ZONDE00/PWR_PCB/README.md

# GS_PCB
Power delivery PCB design files
