ZONDE00/PWR_PCB/PWR_PCB.kicad_pcb

## KiCad design PWR_PCB.kicad_pcb (2022-12-13)

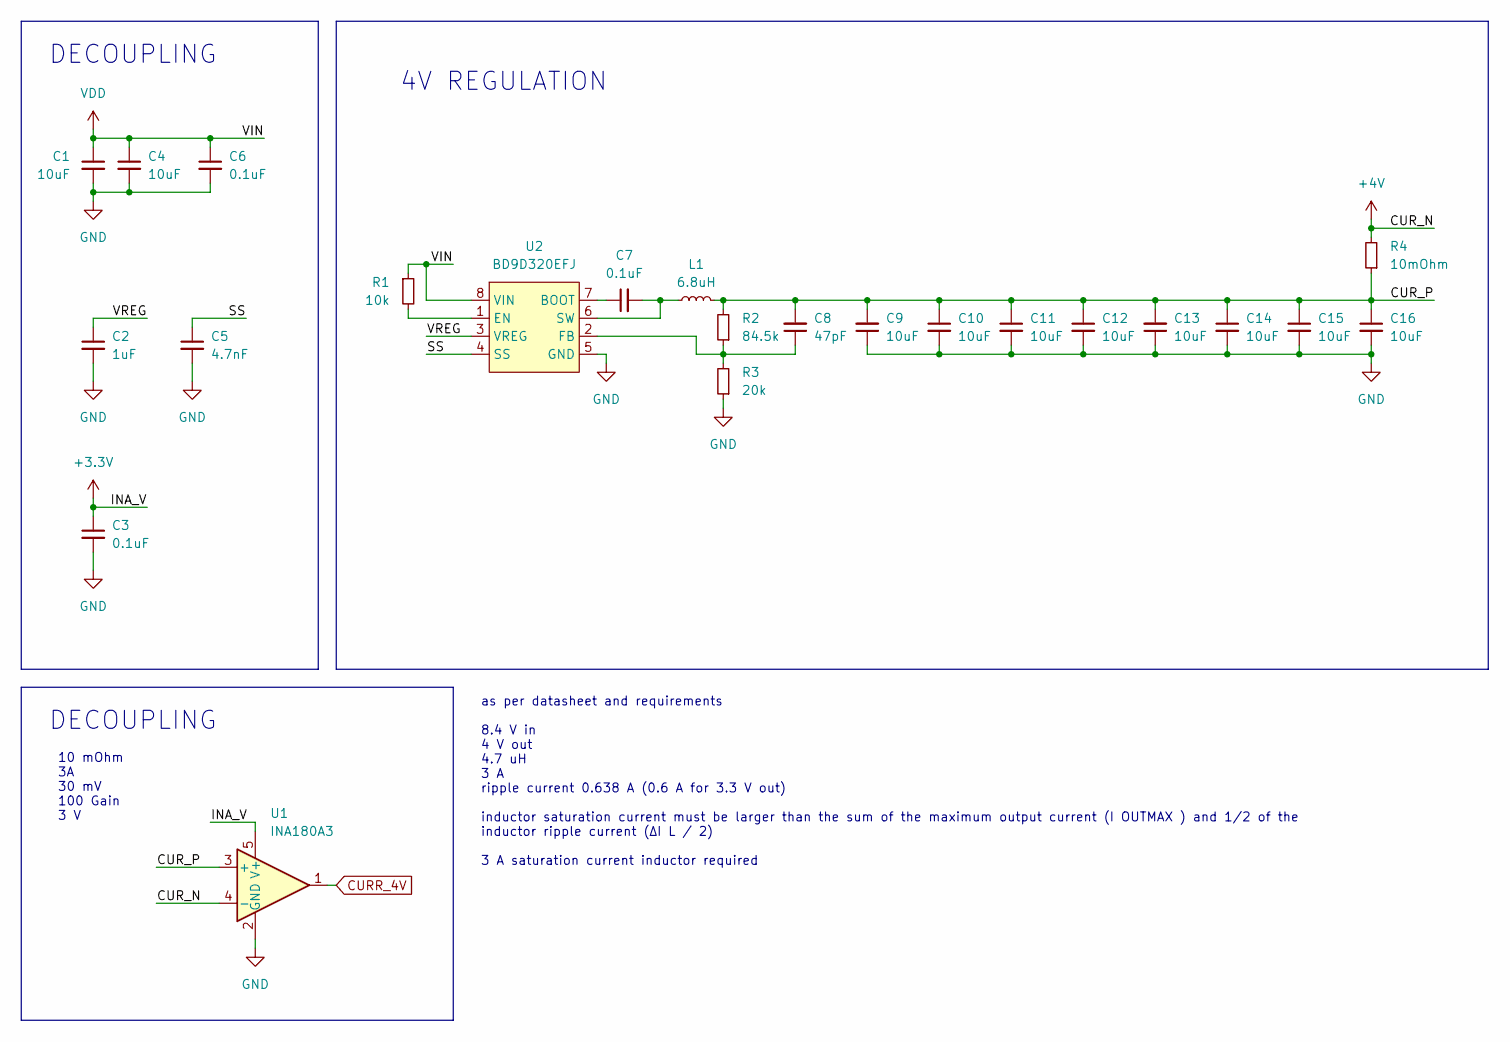
[picture p1: schematic power4v.kicad_sch]

Parts:
C1, C4, C9, C10, C11, C12, C13, C14, C15, C16: 10uF; C_0805_2012Metric
C2: 1uF; C_0603_1608Metric
C3, C6, C7: 0.1uF; C_0402_1005Metric
C5: 4.7nF; C_0402_1005Metric
C8: 47pF; C_0402_1005Metric
L1: 6.8uH; HM72L-06306R8
R1: 10k; R_0402_1005Metric
R2: 84.5k; R_0402_1005Metric
R3: 20k; R_0402_1005Metric
R4: 10mOhm; 0508
U1: INA180A3; SOT-23-5
U2: BD9D320EFJ; HSOP-8-1EP_3.9x4.9mm_P1.27mm_EP2.41x3.1mm

Connections:
3V3: C3.1, U1.5 (V+); also elsewhere on the board
4V: R4.2, U1.4 (-); also elsewhere on the board
/POWER_4V/CUR_P: C8.2, C9.2, C10.1, C11.1, C12.1, C13.2, C14.1, C15.1, C16.1, L1.2, R2.2, R4.1, U1.3 (+)
/POWER_4V/SS: C5.1, U2.4 (SS)
/POWER_4V/VREG: C2.1, U2.3 (VREG)
CURR_4V: U1.1; also elsewhere on the board
GND: C1.2, C2.2, C3.2, C4.2, C5.2, C6.2, C9.1, C10.2, C11.2, C12.2, C13.1, C14.2, C15.2, C16.2, R3.1, U1.2 (GND), U2.5 (GND), U2.9 (GND); also elsewhere on the board
unnamed: C7.1, U2.7 (BOOT)
unnamed: C7.2, L1.1, U2.6 (SW)
unnamed: C8.1, R2.1, R3.2, U2.2 (FB)
unnamed: R1.2, U2.1 (EN)
VDD: C1.1, C4.1, C6.1, R1.1, U2.8 (VIN); also elsewhere on the board

Notes on the sheet:
4V REGULATION
as per datasheet and requirements 8.4 V in 4 V out 4.7 uH 3 A ripple current 0.638 A (0.6 A for 3.3 V out) inductor saturation current must be larger than the sum of the maximum output current (I OUTMAX ) and 1/2 of the inductor ripple current (∆I L / 2) 3 A saturation current inductor required
DECOUPLING
10 mOhm 3A 30 mV 100 Gain 3 V

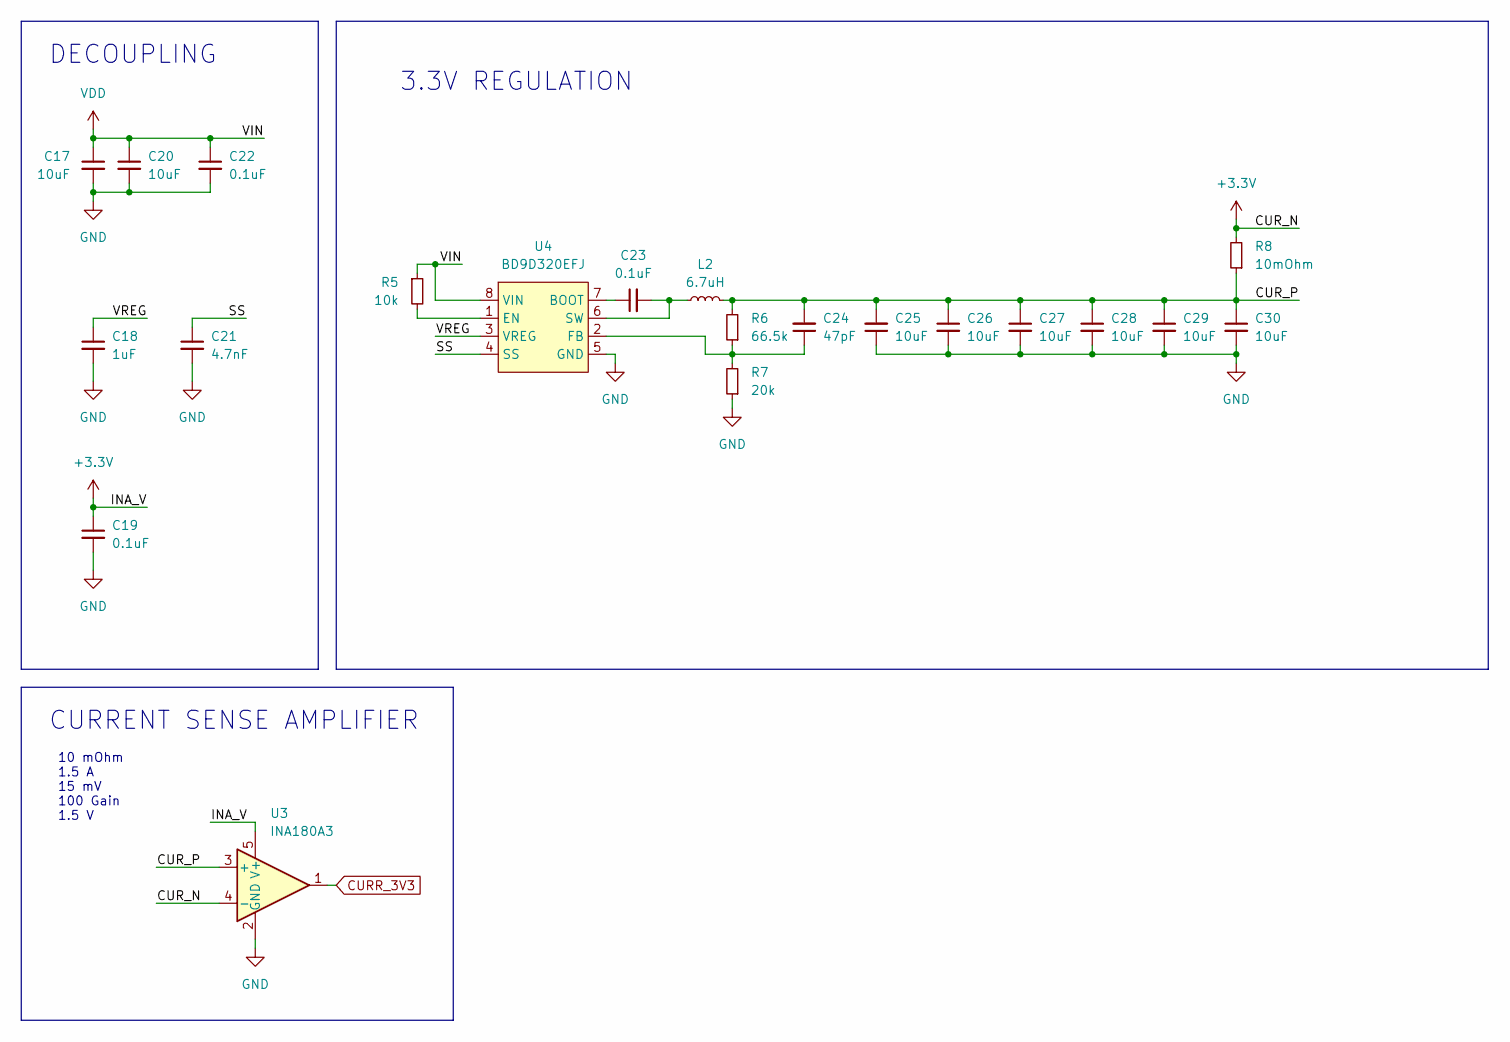
[picture p2: schematic power3v3.kicad_sch]

Parts:
C17, C20, C25, C26, C27, C28, C29, C30: 10uF; C_0805_2012Metric
C18: 1uF; C_0603_1608Metric
C19, C22, C23: 0.1uF; C_0402_1005Metric
C21: 4.7nF; C_0402_1005Metric
C24: 47pF; C_0402_1005Metric
L2: 6.7uH; HM72L-06306R8
R5: 10k; R_0402_1005Metric
R6: 66.5k; R_0402_1005Metric
R7: 20k; R_0402_1005Metric
R8: 10mOhm; 0508
U3: INA180A3; SOT-23-5
U4: BD9D320EFJ; HSOP-8-1EP_3.9x4.9mm_P1.27mm_EP2.41x3.1mm

Connections:
3V3: C19.1, R8.2, U3.4 (-), U3.5 (V+); also elsewhere on the board
/POWER_3V3/CUR_P: C24.2, C25.2, C26.1, C27.1, C28.1, C29.1, C30.1, L2.2, R6.2, R8.1, U3.3 (+)
/POWER_3V3/SS: C21.1, U4.4 (SS)
/POWER_3V3/VREG: C18.1, U4.3 (VREG)
CURR_3V3: U3.1; also elsewhere on the board
GND: C17.2, C18.2, C19.2, C20.2, C21.2, C22.2, C25.1, C26.2, C27.2, C28.2, C29.2, C30.2, R7.1, U3.2 (GND), U4.5 (GND), U4.9 (GND); also elsewhere on the board
unnamed: C23.1, U4.7 (BOOT)
unnamed: C23.2, L2.1, U4.6 (SW)
unnamed: C24.1, R6.1, R7.2, U4.2 (FB)
unnamed: R5.2, U4.1 (EN)
VDD: C17.1, C20.1, C22.1, R5.1, U4.8 (VIN); also elsewhere on the board

Notes on the sheet:
10 mOhm 1.5 A 15 mV 100 Gain 1.5 V
CURRENT SENSE AMPLIFIER
3.3V REGULATION
DECOUPLING

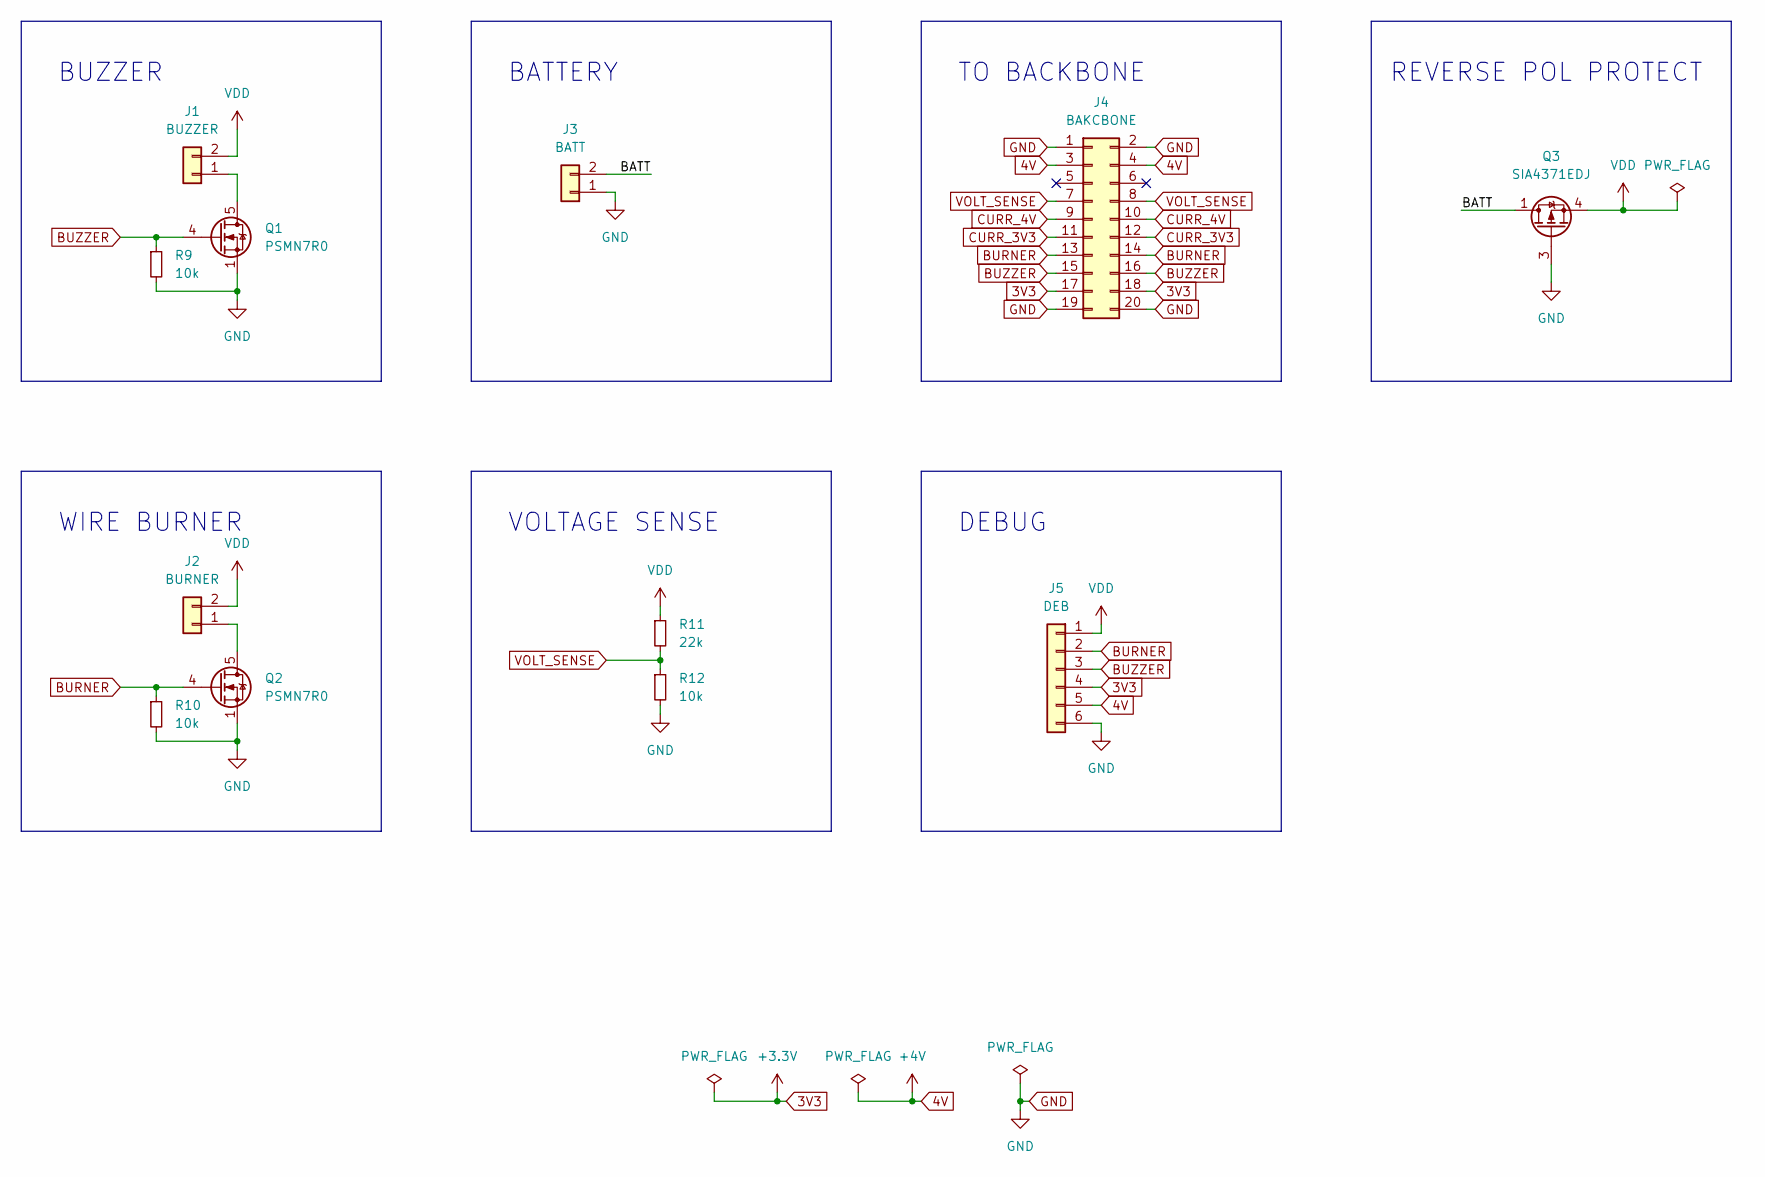
[picture p3: schematic misc.kicad_sch]

Parts:
J1: BUZZER; PinHeader_1x02_P2.54mm_Vertical
J2: BURNER; PinHeader_1x02_P2.54mm_Vertical
J3: BATT; PinHeader_1x02_P2.54mm_Vertical
J4: BAKCBONE; PinSocket_2x10_P2.54mm_Horizontal
J5: DEB; PinSocket_1x06_P2.54mm_Horizontal
Q1, Q2: PSMN7R0; LFPAK33
Q3: SIA4371EDJ; Vishay_PowerPAK_SC70-6L_Single
R9, R10: 10k; R_0402_1005Metric
R11: 22k; R_0603_1608Metric
R12: 10k; R_0603_1608Metric

Connections:
3V3: J4.17, J4.18, J5.4; also elsewhere on the board
4V: J4.3, J4.4, J5.5; also elsewhere on the board
/MISC/BATT: J3.2, Q3.1 (D)
BURNER: J4.13, J4.14, J5.2, Q2.4 (G), R10.1
BUZZER: J4.15, J4.16, J5.3, Q1.4 (G), R9.1
CURR_3V3: J4.11, J4.12; also elsewhere on the board
CURR_4V: J4.9, J4.10; also elsewhere on the board
GND: J3.1, J4.1, J4.2, J4.19, J4.20, J5.6, Q1.1 (S), Q1.2 (S), Q1.3 (S), Q2.1 (S), Q2.2 (S), Q2.3 (S), Q3.3 (G), R9.2, R10.2, R12.2; also elsewhere on the board
unnamed: J1.1, Q1.5 (D)
unnamed: J2.1, Q2.5 (D)
VDD: J1.2, J2.2, J5.1, Q3.4 (S), R11.1; also elsewhere on the board
VOLT_SENSE: J4.7, J4.8, R11.2, R12.1

Notes on the sheet:
BUZZER
REVERSE POL PROTECT
DEBUG
WIRE BURNER
BATTERY
VOLTAGE SENSE
TO BACKBONE

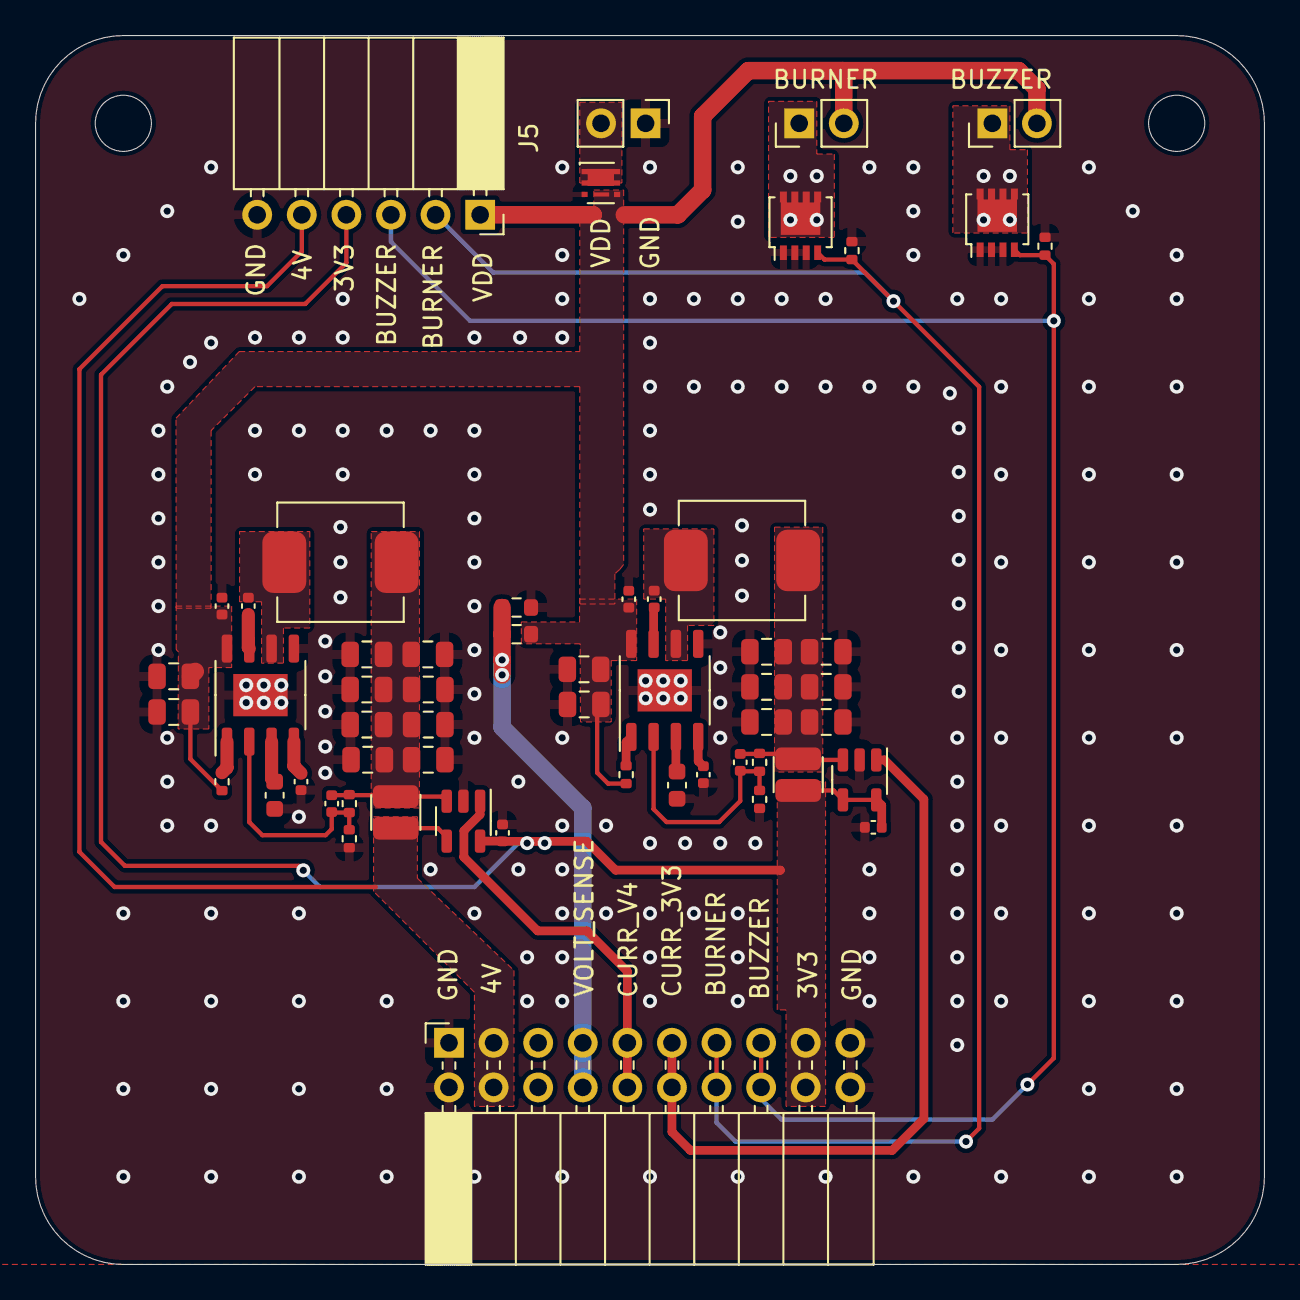
[picture p4: board PWR_PCB.kicad_pcb from above]

Board: 2 copper layers, 70.0 x 70.0 mm, 58 parts (0 on the bottom side), 26 nets.

Other parts of the board:
H1, H2: MountingHole; MountingHole_3.2mm_M3
