ZONDE00/PWR_PCB/(commit log)

2022-09-22 First version for PCB
    [PWR_PCB.kicad_pcb, PWR_PCB.kicad_sch, misc.kicad_sch, power3v3.kicad_sch, power4v.kicad_sch]
2022-09-24 Added debug things
    [PWR_PCB.kicad_pcb, PWR_PCB.kicad_sch, misc.kicad_sch]
2022-09-24 Reverse polarity protection
    [PWR_PCB.kicad_pcb, PWR_PCB.kicad_sch, misc.kicad_sch]
2022-09-25 Changed ressistor values
    [PWR_PCB.kicad_sch, misc.kicad_sch, power4v.kicad_sch]
